jbilander/RA5-512K/(threads)

Thread 1 (2023-08-17):

Slow Ram

retro60s, 2023-08-17:
Hi dear Jorgen, I made this board but there are some problems:
1. My Amiga 500 (1.3) recognizes this RAM as Slow Ram!
2. The Amigakit cannot recognize the clock chip, but Workbench recognizes that! What is the cause?

jbilander, 2023-08-17:
Hi, to map it as chip ram you'll need an ECS Agnus 8372A or better (also called Fat Agnus) in your machine and then do some solder-jumper settings on the motherboard.
https://lyonsden.net/upgrade-amiga-a500-1mb-chip-ram/
Also the card has a jumper JP1 where you can put a jumper on to assert (ground) the EXRAM-line that goes to GARY-chip instead of cutting the trace at JP7A (on Rev.6 motherboard)
2. I'm not sure what you mean with AmigaKit? The CLK doesn't show up in Amiga Test Kit but works in WB?

jbilander, 2023-08-17:
Sorry I think JP1 should be open (not grounded) when configuring for 1 MB chip and no need to cut JP7A.

retro60s, 2023-08-17:
Thanks for your quick reply.
But before this , I had a simple RAM board that added 512kb of chip ram to my Amiga 500 (Rev.6) without any modification:
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
and I transferred the IC RAMs from it to the new board.

2.Sorry, that's what I meant too, "AmigaTestKit"
Yes that's right the CLK doesn't show up in Amiga Test Kit but works in WB! What is the problem?

jbilander, 2023-08-17:
Ok, then the modifications are already done to your motherboard. This was a very common mod that people did back in the days on Rev 6A motherboard. You can verify that the JP2-setting on your motherboard looks like on pic here:
https://lyonsden.net/wordpress_s/wp-content/uploads/2018/04/img_20180216_2231171371319955.jpg
with that set and JP1 open on the memcard it should show up as chip ram. You can verify with a multimeter (continuity check) that the trace going to Gary pin 32 isn't grounded.
2. Regarding the clock, hmm strange, can you set the clock in WB (with the "date" command and "setclock opt save" to store it and it shows correct date and time at next reboot? (requires a battery populated on the memcard). What type of RTC-chip are you using? If sourced from AliExpress they can be dodgy, remarked bad chips. Also double check the soldering and the crystal and caps. Do you have another one to try with?

retro60s, 2023-08-18:
It seems that the mod has not been done:
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

I think the Chinese Clock IC is fake and of poor quality
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

I replaced it with another one, but neither Amigatestkid nor Workbench recognized it!
