jbilander/RA5-512K/(list of files, drawings)

Other design files:
RA5-512K.dip
